ab638/Senior-Project/Documentation/IMG_20190321_185306.jpg

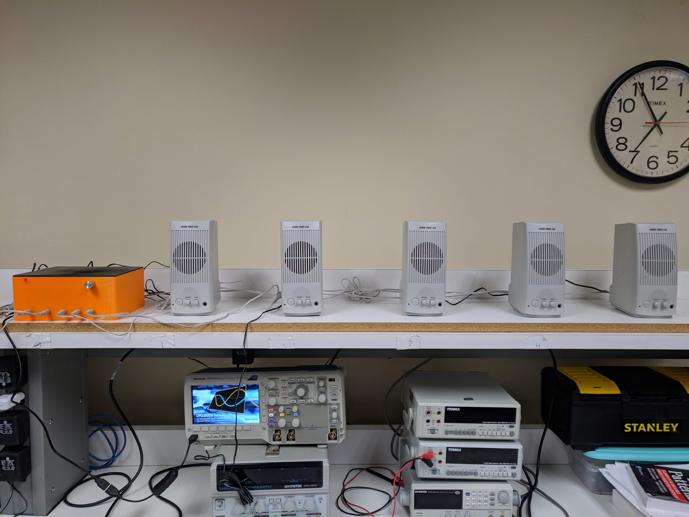
Documentation/IMG_20190321_185306.jpg
