ab638/Senior-Project/Documentation/Poster Draft V1.pptx

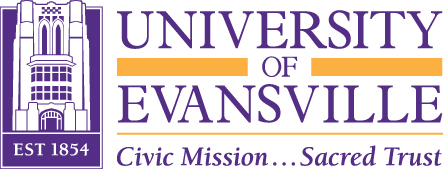
[picture p17: figure]

Phased Array in Sound
Austin Brummett, EE
Advisor: Dr. Blandford

Software Flow Chart

Abstract
The phased array in sound generates a tone via the STM32F446RE microcontroller that can be phased adjusted by the user through a potentiometer. This creates a sense of directional sound outputting from a line array of speakers.

Features
- Approximately 1kHz 8-bit sinusoidal output tone sampled at 44.1kHz via a Timer Interrupt
- Works with any five speakers with internal input amplifiers and a 3.5mm jack.
- Adjustable by potentiometer.


Final Design

Hardware Flow Chart

Final Results
- This project is tested by having a listener walk across the array to detect a change in the direction of the sound.
- An oscilloscope was used to prove that the sine waves are phase shifted.
