ab638/Senior-Project/Documentation/pcb.PNG

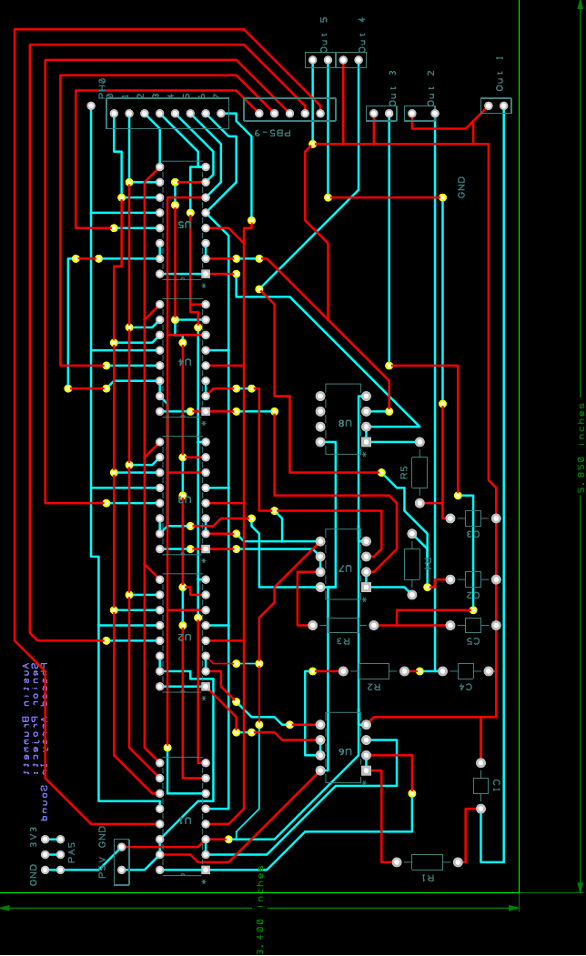
Documentation/pcb.PNG
