ab638/Senior-Project/Documentation/Parts Lists-Budget.xlsx

Sheet: Budgeted Part List
Part Name | Manufacturer Part Number | Home Depot SKU | DigiKey Part Number | Price/Unit | Quantity | Total Price
IC 8Bit 10us Octal DAC S/O 16-Dip | TLV5628IN |  | 296-3062-5-ND | 7.33 | 2 | 14.66
8 Ohm 3W Top Port Speaker | AS07108PO-3-R |  | 668-1240-ND | 4.25 | 6 | 25.5
Assorted Resistors |  |  | N/A | Stock Room | TBD | 0
Assorted Capacitors |  |  | N/A | Stock Room | TBD | 0
10kΩ Potentiometer |  |  | N/A | Stock Room | 1 | 0
PCB (Pack of 1) |  |  | N/A | 55.37 | 1 | 55.37
CONN JACK MONO 3.5MM R/A | MJ-3536 |  | CP-3536-ND | 1.25 | 1 | 1.25
Dual Operational Amplifier | LM356 |  | N/A | Stock Room | 6 | 0
Audio Jack 3.5mm | ----- | ----- | N/A | Stock Room | 5 | 0
STM32F446RET Nucleo Board |  |  | N/A | Owned | 1
Soundforce 540 |  |  |  | 58.97 | 1 | 58.97
8 bit single channel DAC | TLC7524 |  |  | Stock Room | 5 | 0
Total Sum | 155.75
Total Budget | 300
Leftover | 144.25
Spent | 155.75
Order 1/Didn’t use | 41.41
Order 2/Speakers | 58.97
Order 3/PCB | 55.37

Sheet: Sheet1
Part Name | Manufacturer Part Number | Price/Unit | Quantity | Total Price
IC 8Bit 10us Octal DAC S/O 16-Dip | TLV5628IN | 7.33 | 2 | 14.66
8 Ohm 3W Top Port Speaker | AS07108PO-3-R | 4.25 | 6 | 25.5
450 Ω Resistors |  | 1.26 | 10 | 12.6
.1µF Capacitors |  | 0.87 | 5 | 4.35
10kΩ Potentiometer |  | 7.7 | 1 | 7.7
PCB (Pack of 1) |  | 55.37 | 1 | 55.37
CONN JACK MONO 3.5MM R/A | MJ-3536 | 1.25 | 1 | 1.25
Dual Operational Amplifier | LM358 | 0.84 | 5 | 4.2
Audio Jack 3.5mm | ----- | 1.25 | 5 | 6.25
STM32F446RET Nucleo Board |  | 20 | 1 | 20
Soundforce 540(Box of 7 pairs) |  | 58.97 | 1 | 58.97
8 bit single channel DAC | TLC7524 | 4.13 | 5 | 20.65
Total Sum | 231.5
Total Budget | 300 | Development Cost | 155.75
Leftover | 144.25 | Final Project Cost | 173.24

Sheet: Order 1
Part Name | Manufacturer Part Number | Home Depot SKU | DigiKey Part Number | Price/Unit | Quantity | Total Price
IC 8Bit 10us Octal DAC S/O 16-Dip | TLV5628IN |  | 296-3062-5-ND | 7.33 | 2 | 14.66 | Didn't use
8 Ohm 3W Top Port Speaker | AS07108PO-3-R |  | 668-1240-ND | 4.25 | 6 | 25.5 | Didn't use
CONN JACK MONO 3.5MM R/A | MJ-3536 |  | CP-3536-ND | 1.25 | 1 | 1.25 | Didn't use
Total Sum | 41.41
 | x``

Sheet: Order 2
Parts Express
Sound Force 540 Speakers | 58.97
