ab638/Senior-Project/Senior Project Design Files/AustinBrummettBoxFile.stl

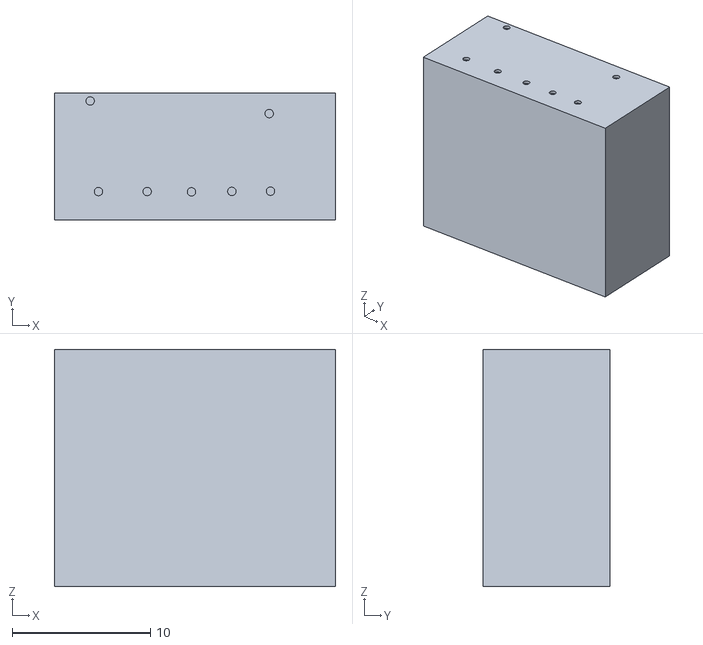
[picture p23: CAD file, 2019-11-20]
Senior Project Design Files/AustinBrummettBoxFile.stl
20.3 x 9.20 x 17.1
