ab638/Senior-Project/Senior Project Design Files/Lid.stl

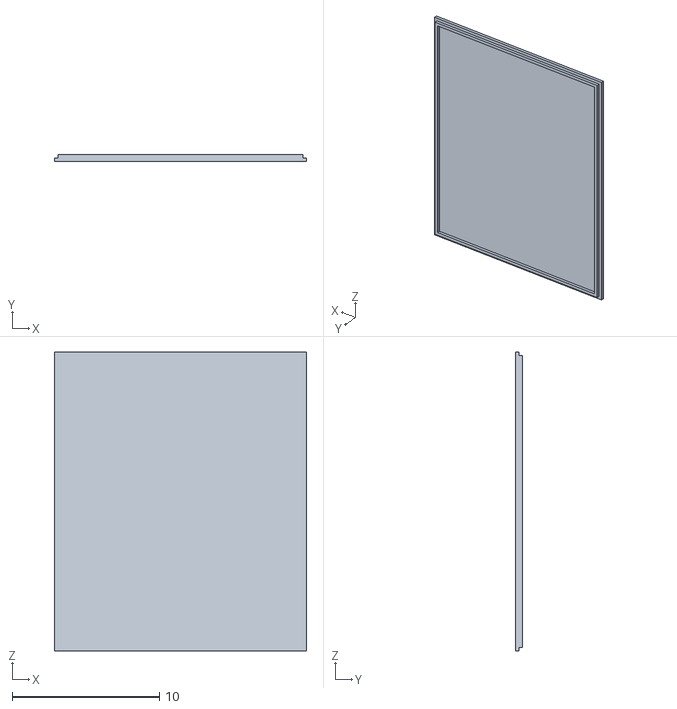
[picture p24: CAD file, 2019-11-20]
Senior Project Design Files/Lid.stl
17.1 x 0.508 x 20.3
