ab638/Senior-Project/Senior Project Design Files/AustinBrummettLidFile.stl

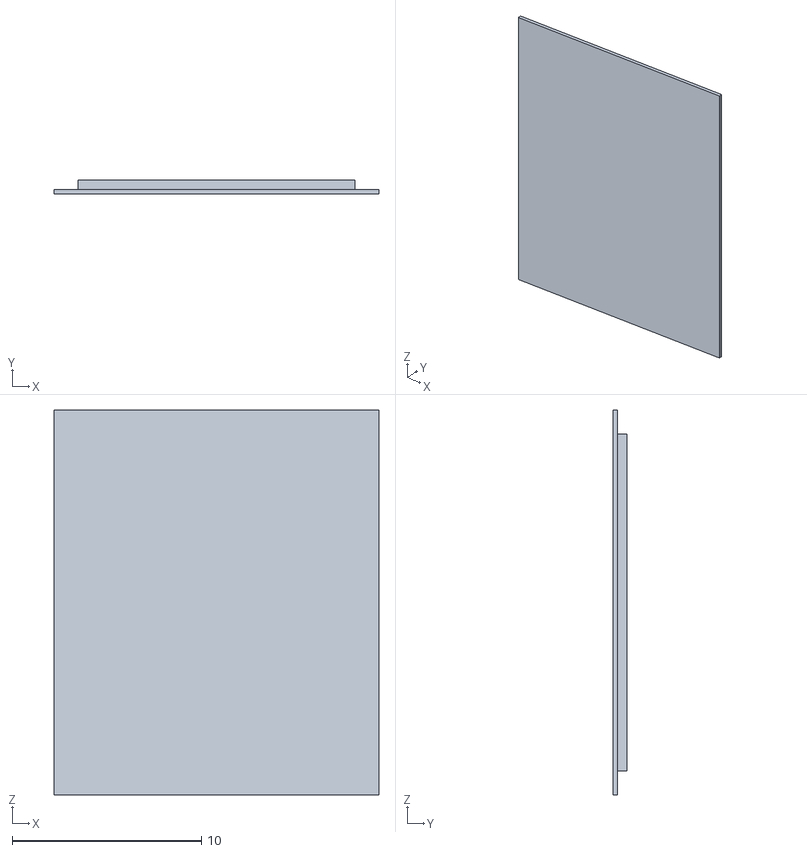
[picture p25: CAD file, 2019-11-20]
Senior Project Design Files/AustinBrummettLidFile.stl
17.1 x 0.762 x 20.3
