ab638/Senior-Project/(list of files, cad)

Other CAD files:
Senior Project Design Files/Lid.ipt
Senior Project Design Files/SeniorProjects.ipt
