ab638/Senior-Project/Documentation/pcb.pdf

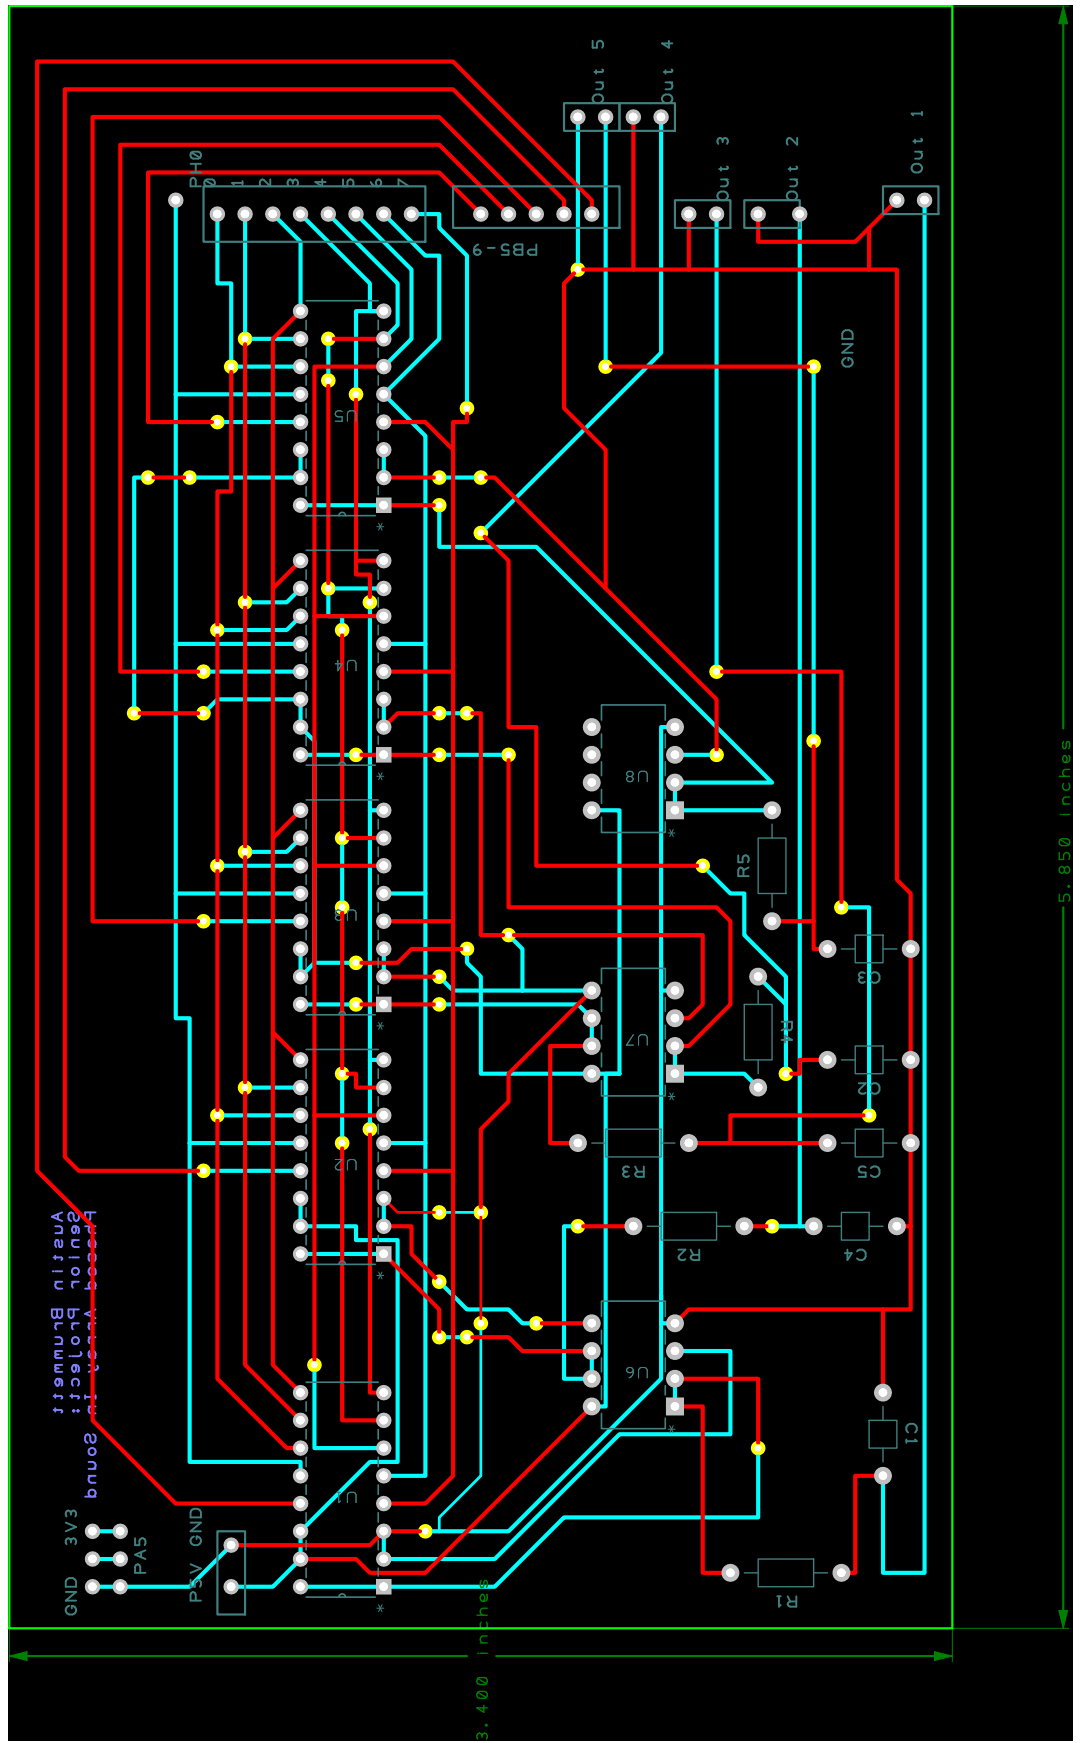
[picture p26: page 1]
