ab638/Senior-Project/(list of files, drawings)

Other design files:
Senior Project Schematics/Final.pcb
Senior Project Schematics/Mark1.pcb
Senior Project Schematics/~Final.pcb
Senior Project Schematics/~Mark1.pcb
